minami88-h/hqdd1/hardware/production/bom.csv

Designator | Footprint | Quantity | Value | LCSC Part #
C1, C2, C3, C4, C5, C6 | 1206 | 6 | 47u
C10, C9 | 0402 | 2 | 0.01u
C11, C12, C28 | 0603 | 3 | 10u
C13 | 0603 | 1 | 4.7u
C14, C15, C16, C20, C21, C22, C23, C24, C27 | 0603 | 9 | 0.1u
C17, C7, C8 | 0603 | 3 | 1u
C18, C19 | 0402 | 2 | 18p
C25, C26 | 0402 | 2 | 22p
D1 | SMASeries_LTF | 1 | SMAJ14CA
D2, D3 | 0603 | 2 | LED
FB1 | 0603 | 1 | BLM18AG601SN1D
IC1, IC2 | TA75S558FLF | 2 | TAR5SB33
J1 | AMASS_XT30UPB-M_1x02_P5.0mm_Vertical | 1 | Conn_01x02
J2 | JST_ZH_B4B-ZR_1x04_P1.50mm_Vertical | 1 | Conn_01x04
J3, J4, J8 | JST_ZH_B2B-ZR_1x02_P1.50mm_Vertical | 3 | Conn_01x02
J5, J6, J7 | pad | 3 | Conn_01x01_Pin
R1, R2, R8 | 0603 | 3 | 10k
R3 | 0603 | 1 | 120
R4, R5 | 0603 | 2 | 4.7k
R6, R7 | 0603 | 2 | 330
SW1 | SW_SPST_PTS810 | 1 | SKRPACE010
U1 | QFN-32-1EP_5x5mm_P0.5mm_EP3.45x3.45mm | 1 | STM32G431KBUx
U2 | RRW0024-MFG | 1 | DRV8311H
U3 | AS5600L-ASOM_AMS | 1 | AS5600L-ASOM
U5 | TSOT-23-8_HandSoldering | 1 | TCAN330
XTAL1 | NX2520SD_NDK-L | 1 | NX2520SD-24MHZ-EXS00A-CS06352
