minami88-h/hqdd1/hardware/hqdd_1.kicad_pcb

## KiCad design hardware/hqdd_1.kicad_pcb (2026-10-30)

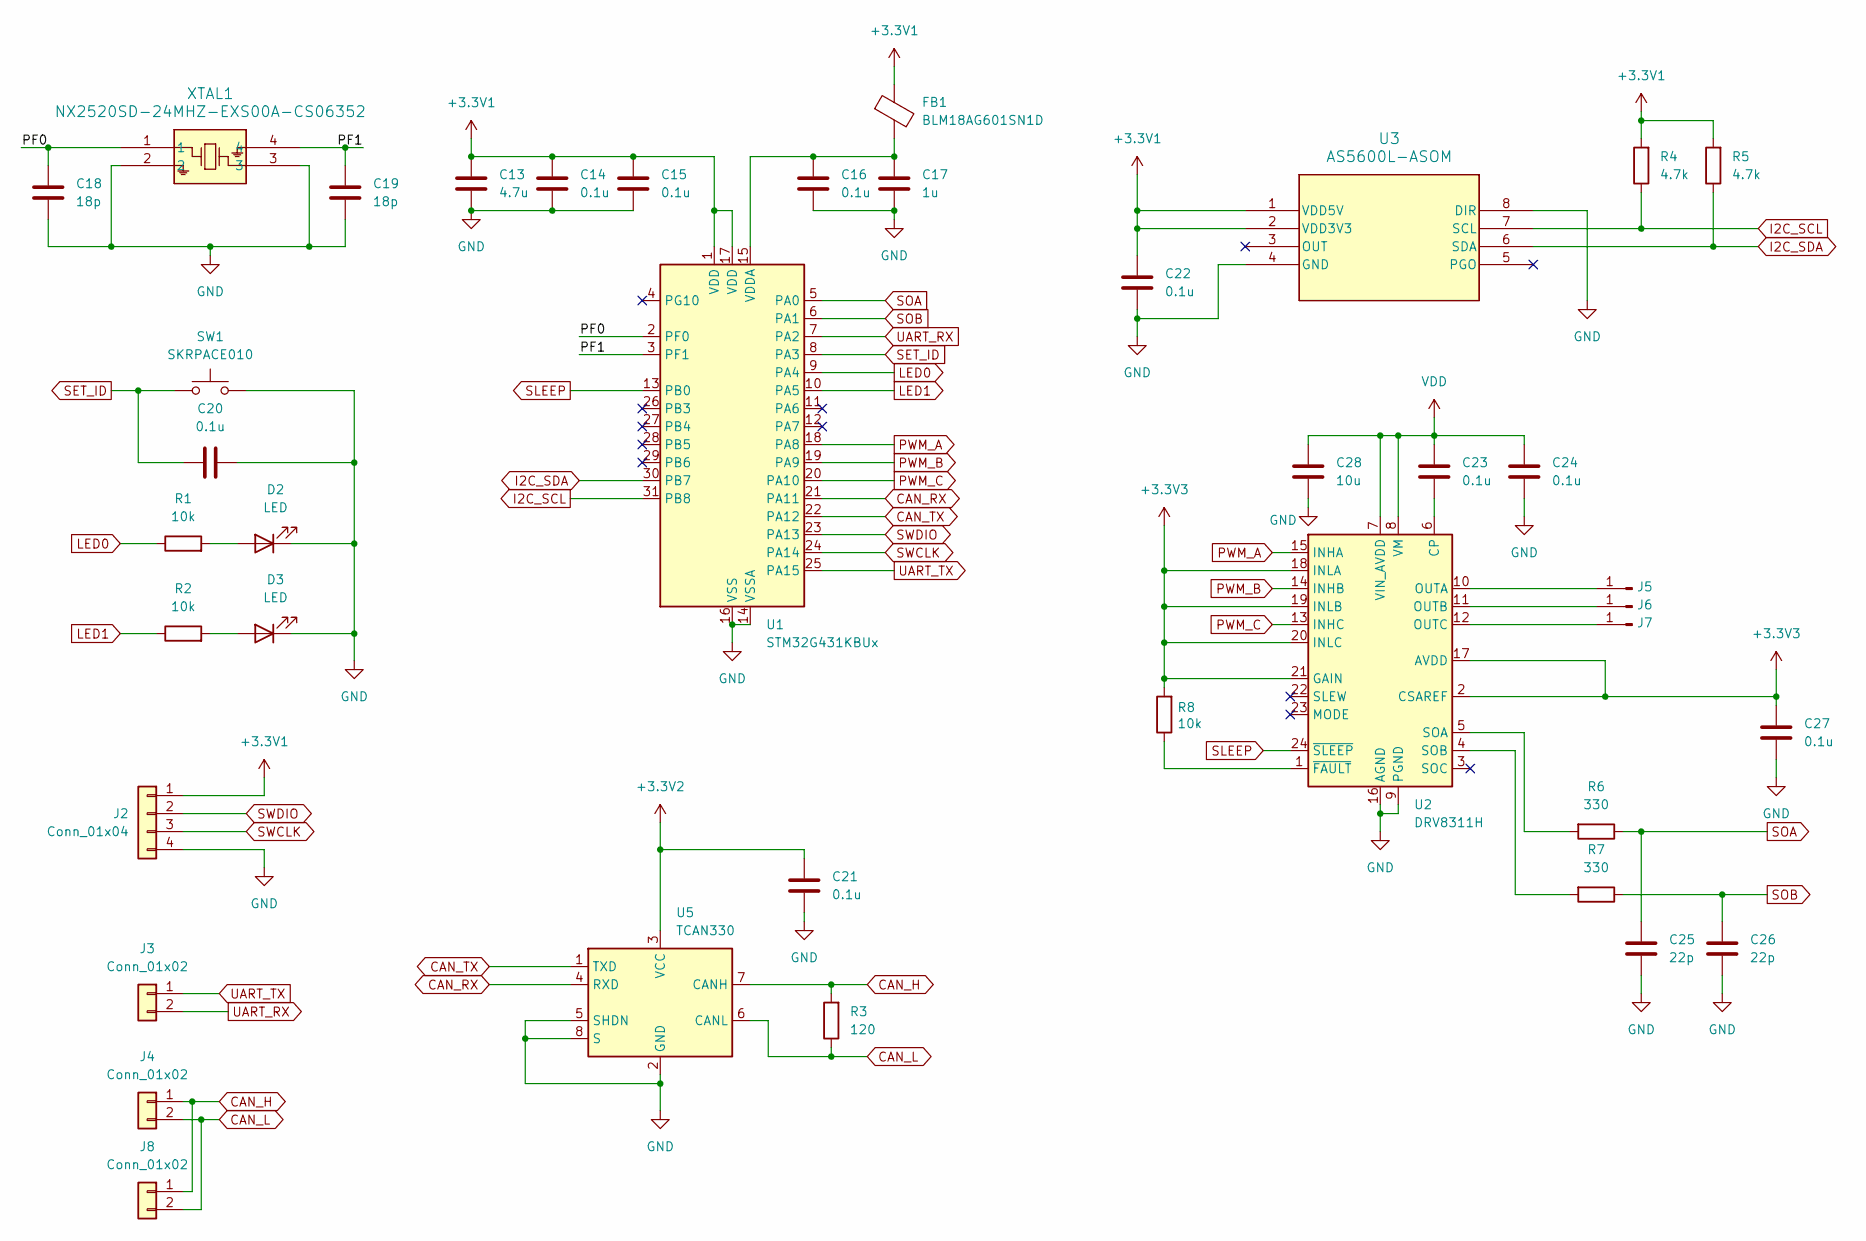
[picture p13: schematic mcu.kicad_sch]

Parts:
C13: 4.7u; C_0603_1608Metric_Pad1.08x0.95mm_HandSolder
C14, C15, C16, C20, C21, C22, C23, C24, C27: 0.1u; C_0603_1608Metric_Pad1.08x0.95mm_HandSolder
C17: 1u; C_0603_1608Metric_Pad1.08x0.95mm_HandSolder
C18, C19: 18p; C_0402_1005Metric_Pad0.74x0.62mm_HandSolder
C25, C26: 22p; C_0402_1005Metric_Pad0.74x0.62mm_HandSolder
C28: 10u; C_0603_1608Metric_Pad1.08x0.95mm_HandSolder
D2, D3: LED; LED_0603_1608Metric_Pad1.05x0.95mm_HandSolder
FB1: BLM18AG601SN1D; C_0603_1608Metric_Pad1.08x0.95mm_HandSolder
J2: Conn_01x04; JST_ZH_B4B-ZR_1x04_P1.50mm_Vertical
J3, J4, J8: Conn_01x02; JST_ZH_B2B-ZR_1x02_P1.50mm_Vertical
J5, J6, J7: Conn_01x01_Pin; pad
R1, R2, R8: 10k; R_0603_1608Metric_Pad0.98x0.95mm_HandSolder
R3: 120; R_0603_1608Metric_Pad0.98x0.95mm_HandSolder
R4, R5: 4.7k; R_0603_1608Metric_Pad0.98x0.95mm_HandSolder
R6, R7: 330; R_0603_1608Metric_Pad0.98x0.95mm_HandSolder
SW1: SKRPACE010; SW_SPST_PTS810
U1: STM32G431KBUx; QFN-32-1EP_5x5mm_P0.5mm_EP3.45x3.45mm
U2: DRV8311H; RRW0024-MFG
U3: AS5600L-ASOM; AS5600L-ASOM_AMS
U5: TCAN330; TSOT-23-8_HandSoldering
XTAL1: NX2520SD-24MHZ-EXS00A-CS06352; NX2520SD_NDK-L

Connections:
+3.3V1: C13.1, C14.1, C15.1, C22.1, FB1.1, J2.1, R4.2, R5.2, U1.1 (VDD), U1.17 (VDD), U3.1 (VDD5V), U3.2 (VDD3V3); also elsewhere on the board
+3.3V2: C21.1, U5.3 (VCC); also elsewhere on the board
+3.3V3: C27.1, R8.2, U2.2 (CSAREF), U2.17 (AVDD), U2.18 (INLA), U2.19 (INLB), U2.20 (INLC), U2.21 (GAIN)
/mcu/PF0: C18.1, U1.2 (PF0), XTAL1.1
/mcu/PF1: C19.1, U1.3 (PF1), XTAL1.4
CAN_H: J4.1, J8.1, R3.2, U5.7 (CANH)
CAN_L: J4.2, J8.2, R3.1, U5.6 (CANL)
CAN_RX: U1.21 (PA11), U5.4 (RXD)
CAN_TX: U1.22 (PA12), U5.1 (TXD)
GND: C13.2, C14.2, C15.2, C16.2, C17.2, C18.2, C19.2, C20.2, C21.2, C22.2, C24.2, C25.2, C26.2, C27.2, C28.2, D2.1 (K), D3.1 (K), J2.4, SW1.2, U1.14 (VSSA), U1.16 (VSS), U1.32 (VSS), U1.33 (VSS), U2.9 (PGND), U2.16 (AGND), U2.25 (PGND), U2.26, U2.27, U2.28, U2.29, U2.30, U3.4 (GND), U3.8 (DIR), U5.2 (GND), U5.5 (SHDN), U5.8 (S), XTAL1.2, XTAL1.3; also elsewhere on the board
I2C_SCL: R4.1, U1.31 (PB8), U3.7 (SCL)
I2C_SDA: R5.1, U1.30 (PB7), U3.6 (SDA)
LED0: R1.1, U1.9 (PA4)
LED1: R2.1, U1.10 (PA5)
unnamed: D2.2 (A), R1.2
unnamed: D3.2 (A), R2.2
unnamed: J5.1 (Pin_1_1), U2.10 (OUTA)
unnamed: J6.1 (Pin_1_1), U2.11 (OUTB)
unnamed: J7.1 (Pin_1_1), U2.12 (OUTC)
unnamed: C16.1, C17.1, FB1.2, U1.15 (VDDA)
unnamed: C23.2, U2.6 (CP)
unnamed: R6.2, U2.5 (SOA)
unnamed: R7.2, U2.4 (SOB)
unnamed: R8.1, U2.1 (~FAULT)
PWM_A: U1.18 (PA8), U2.15 (INHA)
PWM_B: U1.19 (PA9), U2.14 (INHB)
PWM_C: U1.20 (PA10), U2.13 (INHC)
SET_ID: C20.1, SW1.1, U1.8 (PA3)
SLEEP: U1.13 (PB0), U2.24 (~SLEEP)
SOA: C25.1, R6.1, U1.5 (PA0)
SOB: C26.1, R7.1, U1.6 (PA1)
SWCLK: J2.3, U1.24 (PA14)
SWDIO: J2.2, U1.23 (PA13)
UART_RX: J3.2, U1.7 (PA2)
UART_TX: J3.1, U1.25 (PA15)
VDD: C23.1, C24.1, C28.1, U2.7 (VIN_AVDD), U2.8 (VM); also elsewhere on the board

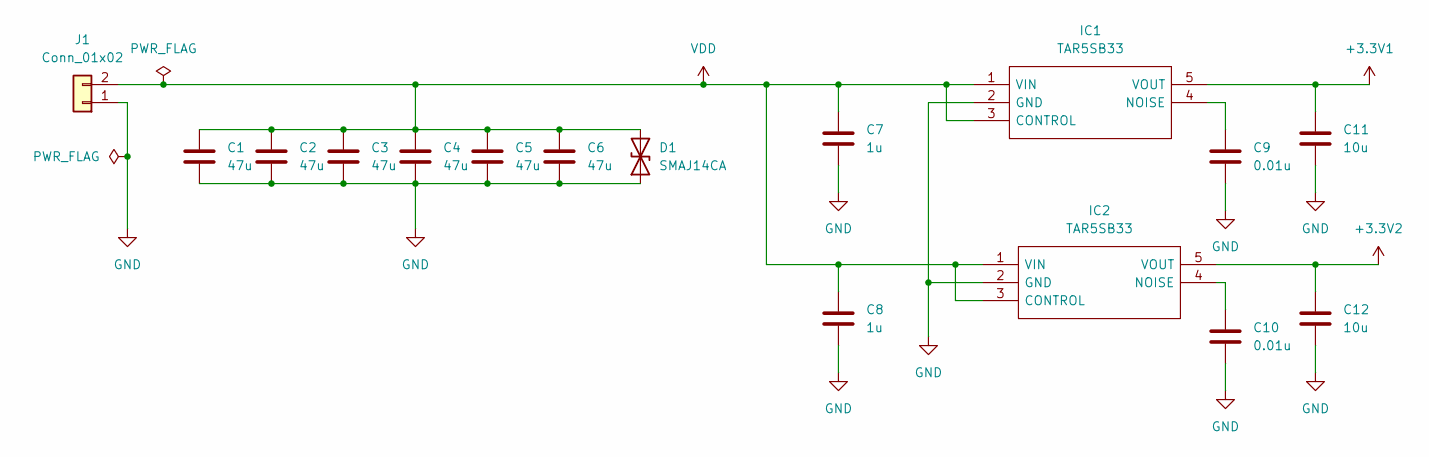
[picture p14: schematic power.kicad_sch]

Parts:
C1, C2, C3, C4, C5, C6: 47u; C_1206_3216Metric_Pad1.33x1.80mm_HandSolder
C7, C8: 1u; C_0603_1608Metric_Pad1.08x0.95mm_HandSolder
C9, C10: 0.01u; C_0402_1005Metric_Pad0.74x0.62mm_HandSolder
C11, C12: 10u; C_0603_1608Metric_Pad1.08x0.95mm_HandSolder
D1: SMAJ14CA; SMASeries_LTF
IC1, IC2: TAR5SB33; TA75S558FLF; Manufacturer_Part_Number TAR5SB33
J1: Conn_01x02; AMASS_XT30UPB-M_1x02_P5.0mm_Vertical

Connections:
+3.3V1: C11.1, IC1.5 (VOUT); also elsewhere on the board
+3.3V2: C12.1, IC2.5 (VOUT); also elsewhere on the board
GND: C1.2, C2.2, C3.2, C4.2, C5.2, C6.2, C7.2, C8.2, C9.2, C10.2, C11.2, C12.2, D1.1 (A1), IC1.2 (GND), IC2.2 (GND), J1.1; also elsewhere on the board
unnamed: C9.1, IC1.4 (NOISE)
unnamed: C10.1, IC2.4 (NOISE)
VDD: C1.1, C2.1, C3.1, C4.1, C5.1, C6.1, C7.1, C8.1, D1.2 (A2), IC1.1 (VIN), IC1.3 (CONTROL), IC2.1 (VIN), IC2.3 (CONTROL), J1.2; also elsewhere on the board

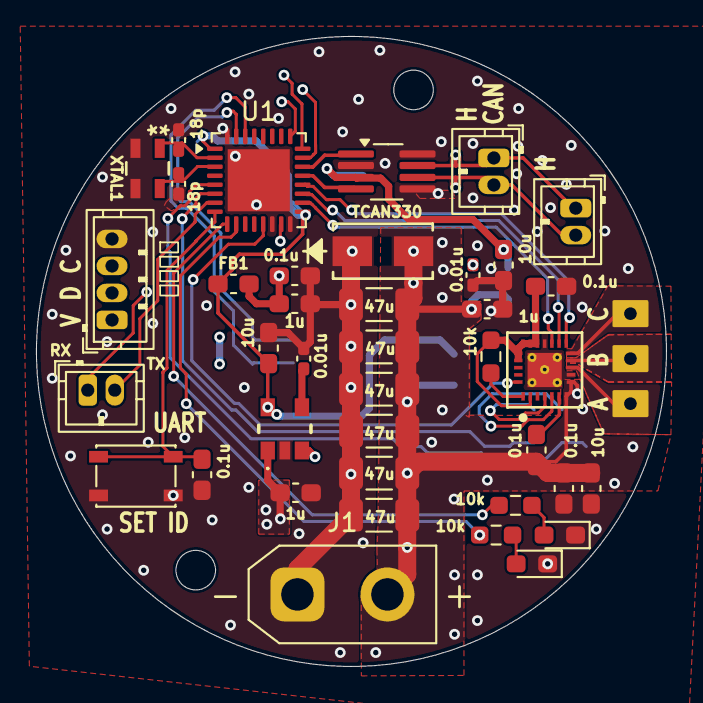
[picture p15: board hqdd_1.kicad_pcb from above]

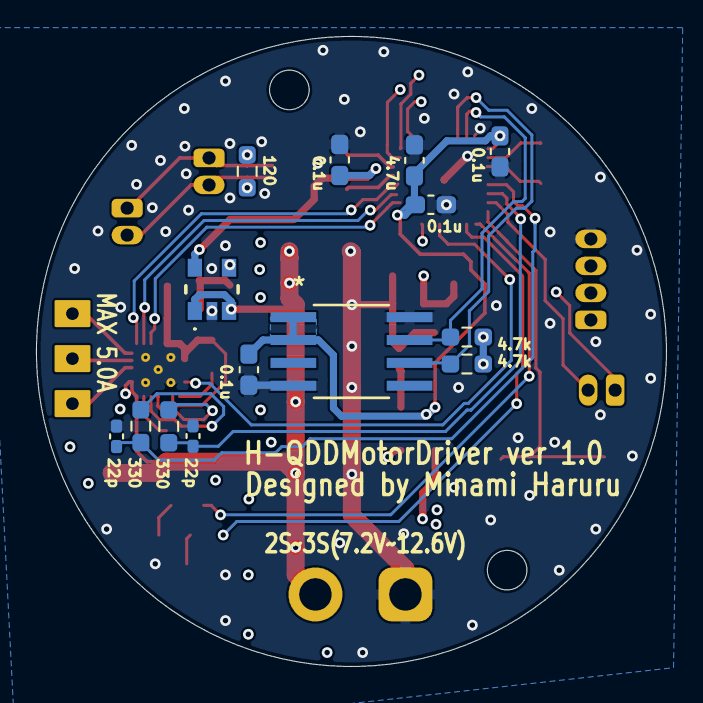
[picture p16: board hqdd_1.kicad_pcb from below]

Board: 4 copper layers, 35.0 x 35.0 mm, 56 parts (14 on the bottom side), 38 nets.
