minami88-h/hqdd1/(commit log)

2026-10-16 HQDD1: 基板(KiCad)・ファームウェア・Web UI・通信仕様書をまとめて公開
    - firmware/: STM32G431 + SimpleFOC の電流FOC、CAN(FDCAN1)/UART通信、パラメータのフラッシュ保存
    - webui/: 操作用Web UI(Web Serial / SocketCAN)
    - hardware/: KiCadプロジェクトと製造データ
    - docs/: CAN/UART通信仕様書(MD/PDF)
    [bom.csv, designators.csv, hqdd_1.kicad_pcb, hqdd_1.kicad_sch, hqdd_1.step, mcu.kicad_sch, positions.csv, power.kicad_sch]
2026-10-16 仕様書のコマンド説明を整理し、LiPo(2S/3S)の表記を明確化
    - 仕様書: 「コマンドとは」「用語」を追加。W/F などが基板に送る文字列であること、
    各コマンドに対応する Web UI の操作を明記。2.4 を書き直し
    - 2S/3S を LiPo のセル数(2セル/3セル直列)と明記(README・仕様書・UI)
2026-10-16 公開ページのUIを修正し、非商用ライセンスを追加
    - UI: https配信時にws://を作ってSecurityErrorで初期化が止まり、グラフが描画されず
    接続方式も切り替わらない不具合を修正
    - UI: Web Serialの接続・切断・読み取りエラー処理を堅牢化(再接続できない問題の対策)、
    エラーを画面上部に表示、UARTのID自動検出を追加
    - ライセンス: ソフトウェアはPolyForm Noncommercial 1.0.0、
    ハードウェア・文書はCC BY-NC 4.0(商用利用は著作権者以外不可)
2026-10-30 PCBをデイジーチェーンに対応
    [bom.csv, designators.csv, hqdd_1.kicad_pcb, mcu.kicad_sch, positions.csv, power.kicad_sch]
